Gralerfics/RTL-SDR-Project/README.md

# RTL-SDR-Project
RTL-SDR 制作与学习实录.

---

## Ver 1.0, 2023.02

包含笔记文档：
- RTL-SDR 简介
- RTL-SDR 简单接收示例
- RTL-SDR 硬件设计制作与调试
- RTL-SDR 驱动程序简析（待完善）
- RTL-SDR 其他上位机处理方式示例（待完善）
- 待续

以及附件（相关软件程序、硬件源工程、参考资料等）。

---

## Collaborators

本文档由 Gralerfics 整理撰写，项目为其与 Ma Guoheng 和 Xie Qijia 同志共同设计制作，由 Wu Guang 老师指导。

特别鸣谢：马同学的焊接手艺。
