Gralerfics/RTL-SDR-Project/附件/参考资料/README.txt

参考资料还包括：
1、【老邵的开源世界】提供的原理图与实物（因未取得许可，暂不包含在该资料中）；
2、各芯片数据手册中的示例电路以及 PCB 布局建议；
3、《软件无线电入门教程——使用LabVIEW设计与实现》一书中的介绍；
4、网上各种 RTL-SDR 实物图观察目测；
等。
