Gralerfics/RTL-SDR-Project/附件/硬件工程/立创 EDA 专业版工程 (.eprj)/README.txt

.eprj 使用立创 EDA 专业版（半离线模式）打开。

.elib 文件为元件封装库，里面是 RTL2832U、R820T 和贴片式 28.8MHz 无源晶振的元件符号和封装，有需要可以自行绘制。
注意：其中使用的 28.8MHz 贴片无源晶振比较难买，最后在拼多多找到的店，常见的是两脚直插式，可以自行更换之。
