Gralerfics/RTL-SDR-Project/附件/软件程序/SDRSharp/README.txt

SDRSharp (SDR#) 是一款开源程序，可以自行编译运行。内部集成多种数据解调算法，可以连接不同的 SDR 硬件（包括 RTL-SDR），实现收听 WFM、AM 广播等功能。
SDRSharp 因为开源，还有大量插件可以使用，详情可见 RTL-SDR 博客或 SDRSharp 官网、官方仓库。

欲下载最新版可参考如下网址：https://airspy.com/download/

【使用方法】
解压后直接运行 SDRSharp.exe 即可。
要注意的是需要先运行解压目录下 install-rtlsdr.bat，安装 RTL-SDR 的驱动程序（如果出错可以手动放进去，驱动就在 Osmocom 文件夹下）。

详见文档。
