Gralerfics/RTL-SDR-Project/附件/软件程序/TVSharp/README.txt

TVSharp 是一个 SDRSharp 的插件，不过是可以独立运行的（这算啥插件）。
它可以控制 SDR 接收并解析模拟电视信号。
