Gralerfics/RTL-SDR-Project/附件/软件程序/Zadig/README.txt

Zadig 用于快速安装 USB 设备驱动。欲使用 RTL-SDR 首先需要使用 Zadig 安装 RTL2832U 的驱动（Windows 平台选择 WinUSB）。

使用方法详见文档。
