Gralerfics/RTL-SDR-Project/5. RTL-SDR 其它上位机处理方式示例.docx

RTL-SDR其他上位机处理方式示例

- SDRSharp等软件处理RTL-SDR接收的信号

见广播收听示例。

- 直接使用驱动程序（CLI）测试RTL-SDR

暂略。

- LabView处理RTL-SDR接收的信号

暂略。

- GNURadio处理RTL-SDR接收的信号

暂略。

- MATLAB处理RTL-SDR接收的信号

暂略。

- 其他语言处理RTL-SDR接收的信号

暂略。
