Gralerfics/RTL-SDR-Project/附件/参考资料/硬件设计参考/ggtoshi.pdf

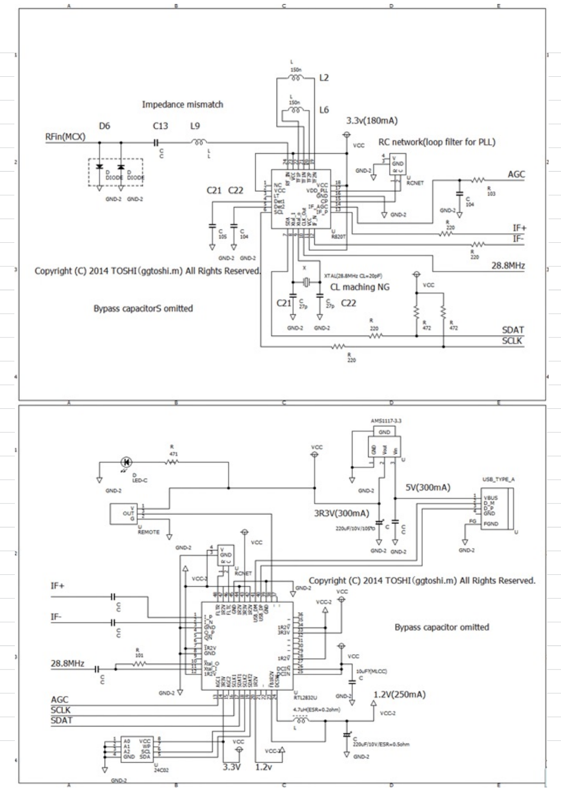
[picture p9: page 1]
