Gralerfics/RTL-SDR-Project/附件/硬件工程/原理图导出版 (.pdf)/Ver 2.0.pdf

# Front

# Back

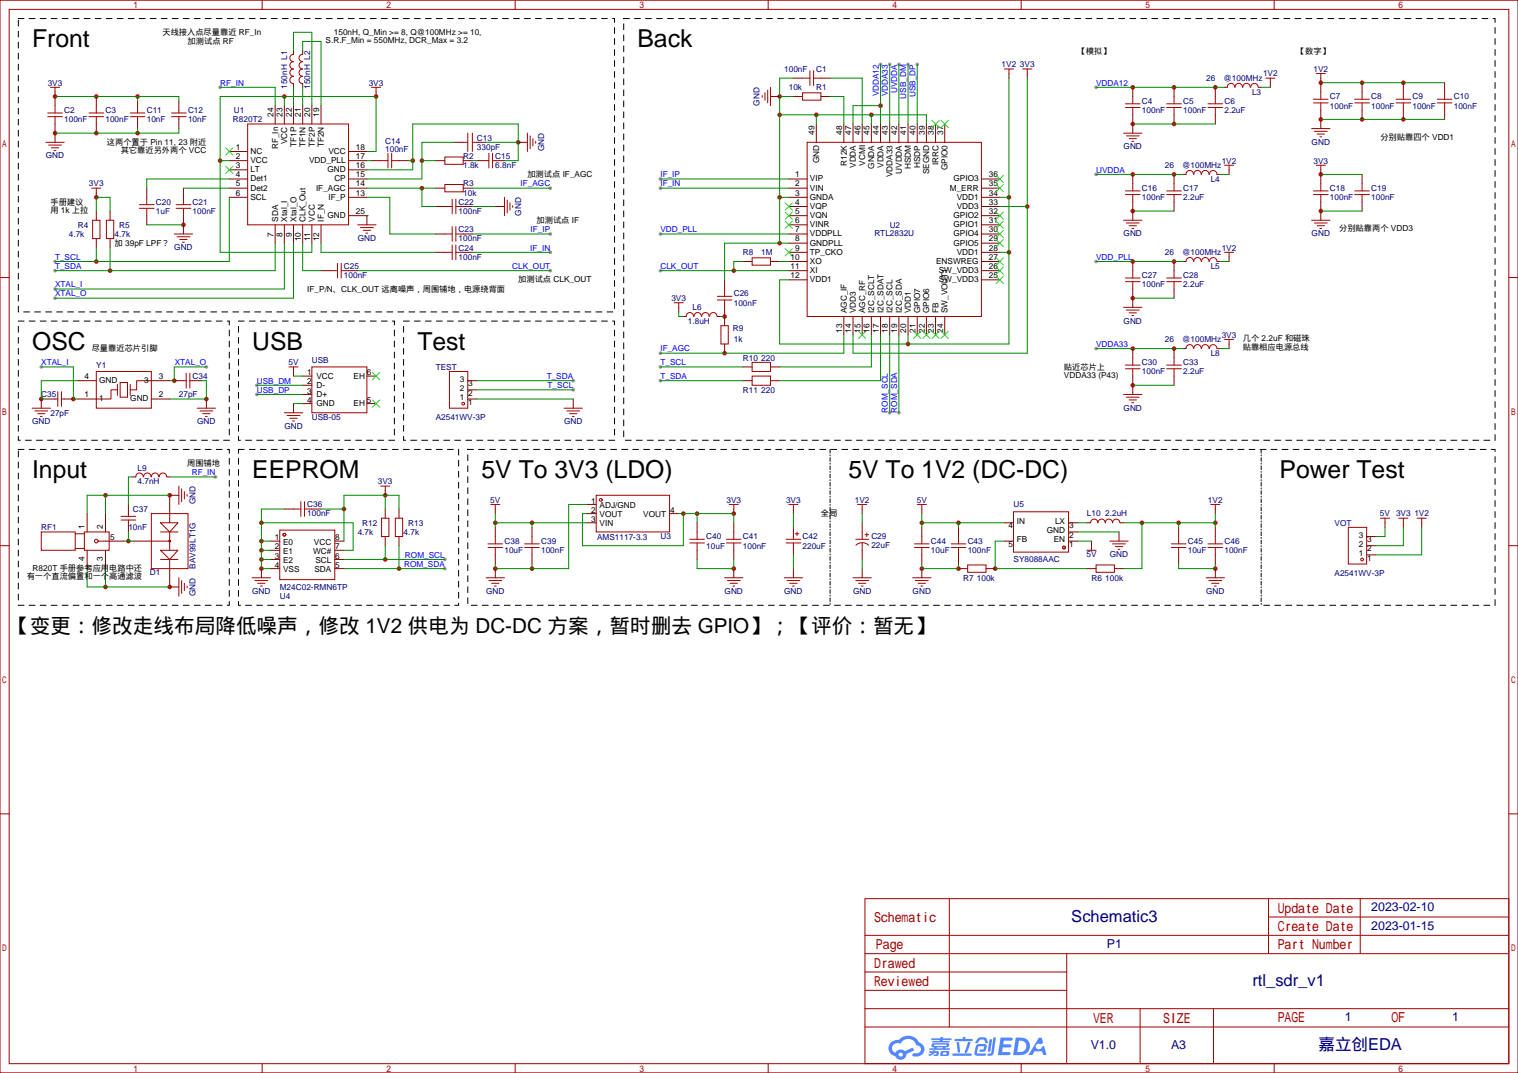
[picture p10: page 1]

GPIO0 37 IRRC 38 SEGND 39 HSDP 40 HSDM 41 UVDDA 42 VDDA33 43 VDDA 44 GNDA 45 VCMI 46 VDDA 47 R12K 48

【变更：修改走线布局降低噪声，修改 1V2 供电为 DC-DC 方案，暂时删去 GPIO】；【评价：暂无】
