Gralerfics/RTL-SDR-Project/(list of files, drawings)

Other design files:
附件/硬件工程/立创 EDA 专业版工程 (.eprj)/rtl_sdr_v1.eprj
